eskyo/RAMBo/docs/images/Rambo-conn-main.jpg

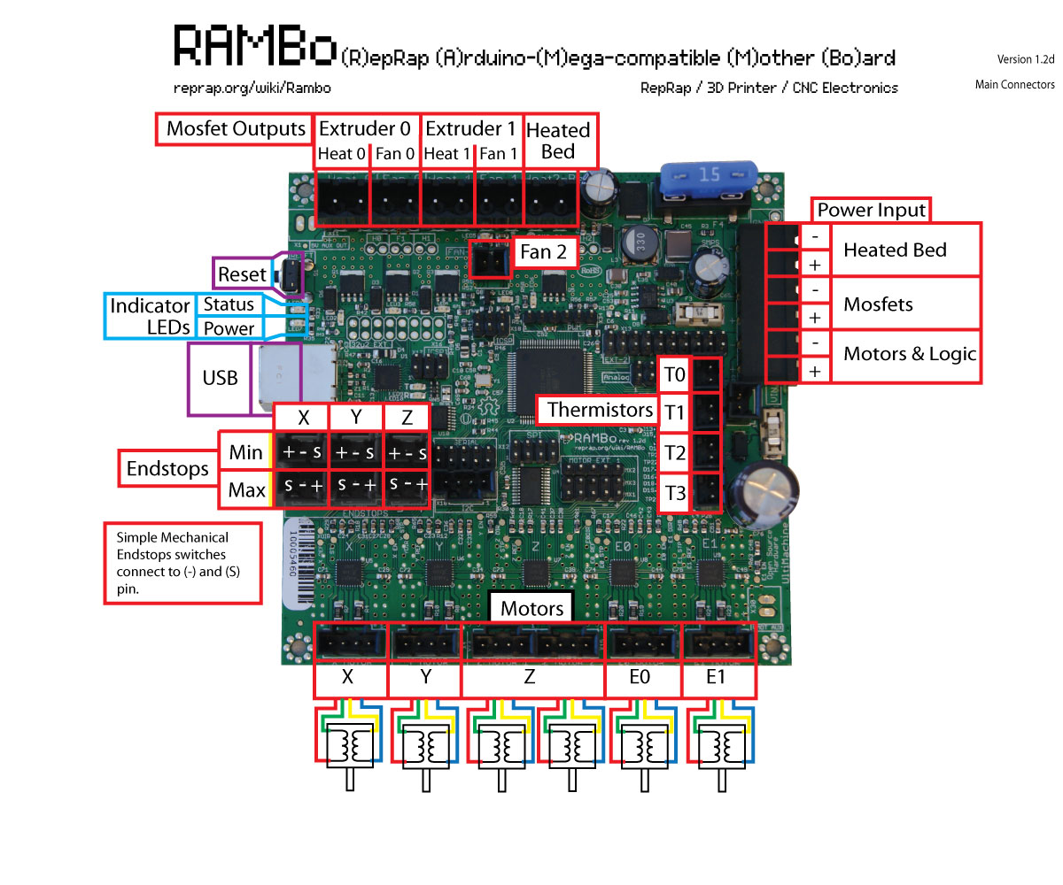
docs/images/Rambo-conn-main.jpg
