eskyo/RAMBo/docs/images/Rambo-fuses.jpg

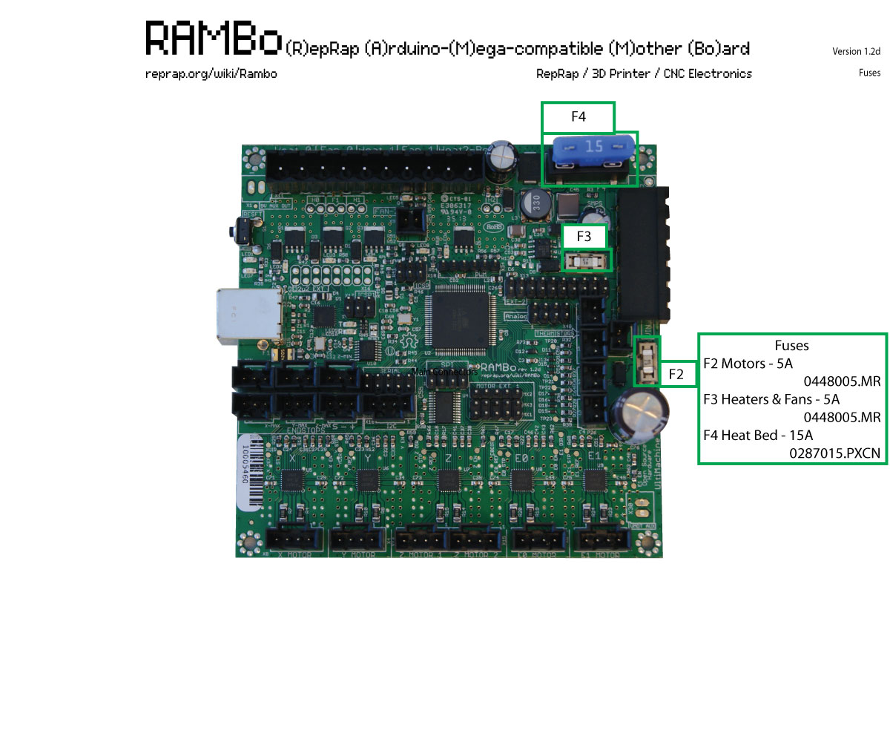
docs/images/Rambo-fuses.jpg
