eskyo/RAMBo/docs/images/Rambo-AuxConn.jpg

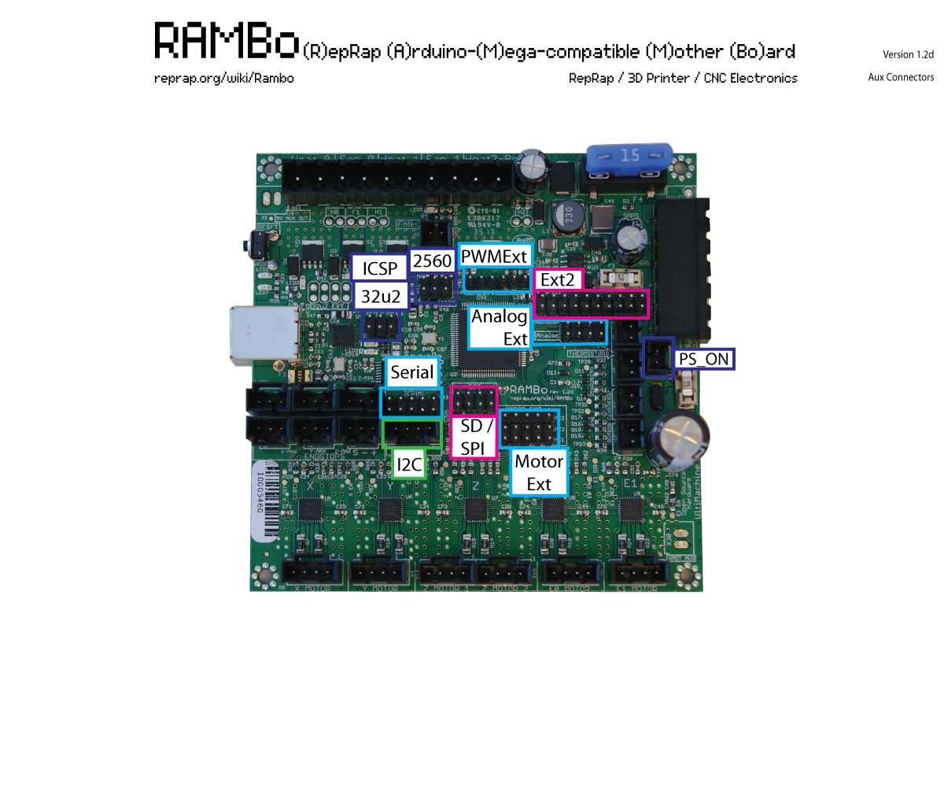
docs/images/Rambo-AuxConn.jpg
