eskyo/RAMBo/docs/images/RAMBo-board.jpg

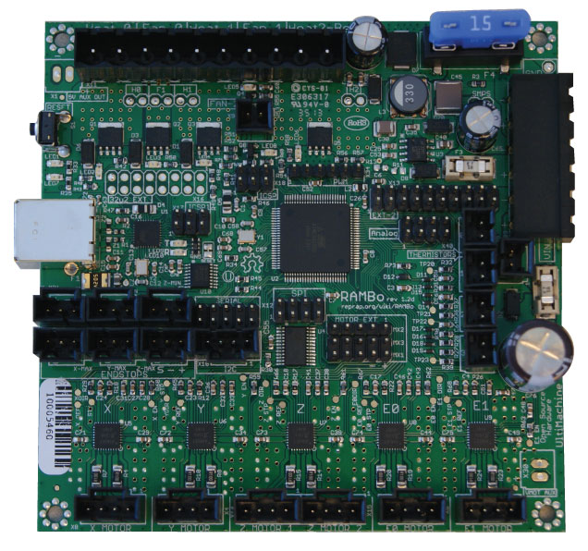
docs/images/RAMBo-board.jpg
