eskyo/RAMBo/docs/images/RAMBo-Schem.png

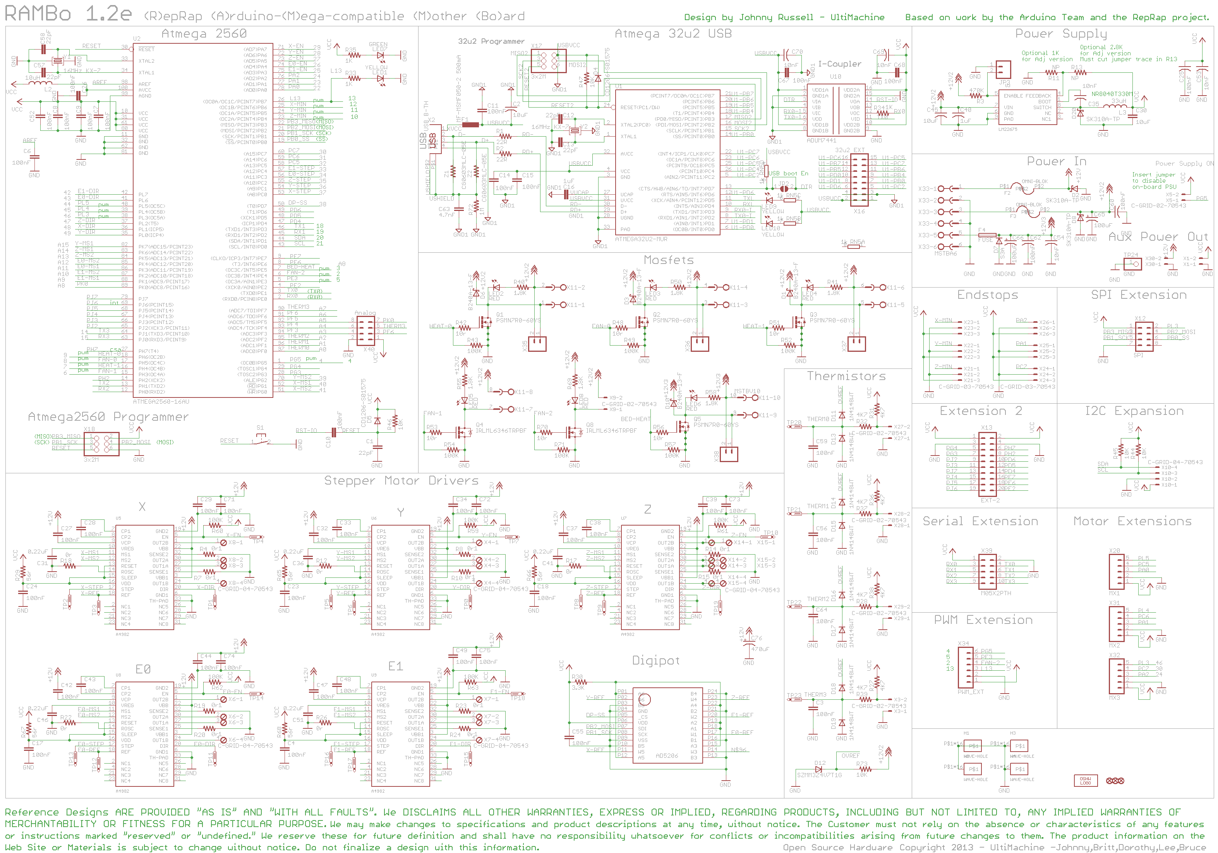
docs/images/RAMBo-Schem.png
