eskyo/RAMBo/docs/images/RAMBo-Silk.png

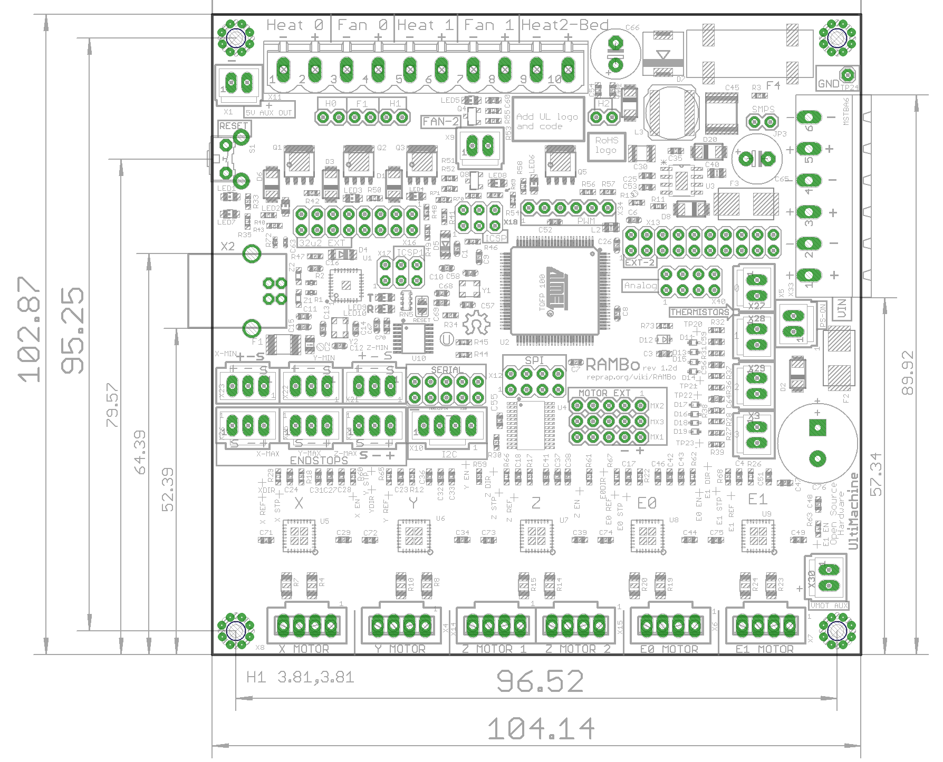
docs/images/RAMBo-Silk.png
