eskyo/RAMBo/past/motorExt1-1.jpg

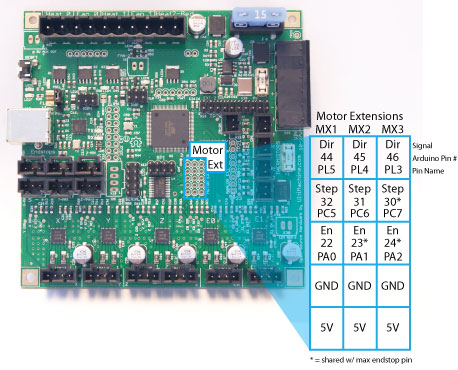
past/motorExt1-1.jpg
