eskyo/RAMBo/pogo_pin_jigs/1.2/RAMBo_top_plate.dxf

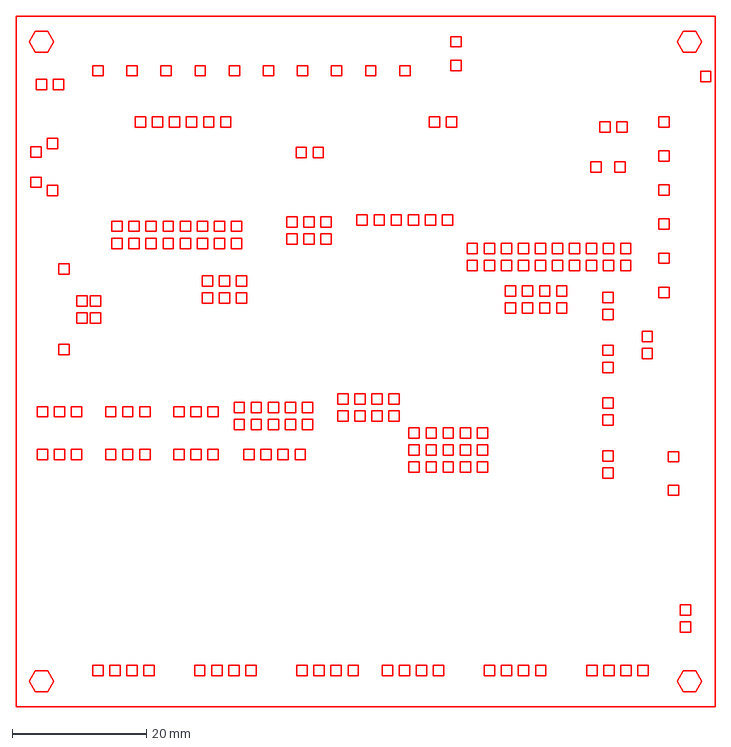
[picture p8: CAD file, 2013-10-01]
pogo_pin_jigs/1.2/RAMBo_top_plate.dxf
104.1 x 102.9 mm
