eskyo/RAMBo/pogo_pin_jigs/1.2/RAMBo_bottom_support.stl

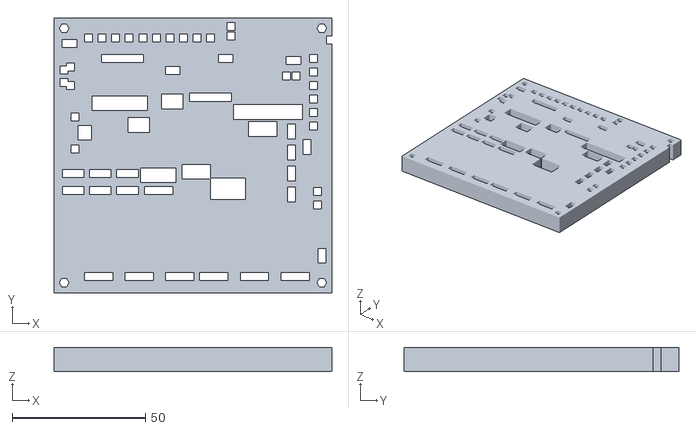
[picture p9: CAD file, 2013-10-01]
pogo_pin_jigs/1.2/RAMBo_bottom_support.stl
104.1 x 102.9 x 9.00
