eskyo/RAMBo/(list of files, cad)

Other CAD files:
pogo_pin_jigs/1.2/RAMBo_bottom_plate.scad
pogo_pin_jigs/1.2/RAMBo_bottom_support.scad
pogo_pin_jigs/1.2/RAMBo_top_plate.scad
