eskyo/RAMBo/docs/RAMBo-manual.pdf

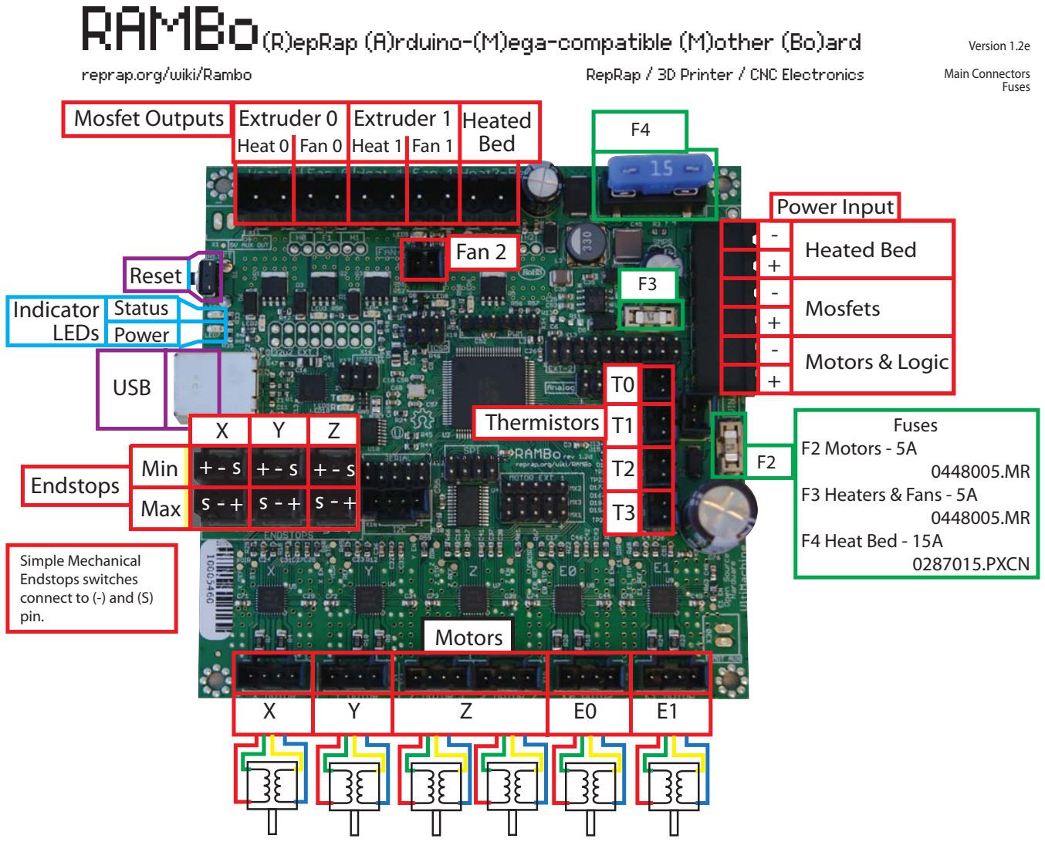
[picture p11: figure]
Fuses F2 Motors - 5A; 0448005.MR F3 Heaters & Fans - 5A 0448005.MR F4 Heat Bed - 15A 0287015.PXCN; Main Connectors; Fuses; Indicator LEDs; Status Power; Reset; USB; Heated Bed; Motors & Logic; Mosfets; Power Input; Mosfet Outputs; Extruder 0; Extruder 1; Fan 2; Heated; Heat 0; Fan 0; Heat 1; Fan 1; Bed; Thermistors; Motors; Endstops; Min; Max; Simple Mechanical Endstops switches connect to (-) and (S) pin.; Version 1.2e; RAMBo(R)epRap (A)rduino-(M)ega-compatible (M)other (Bo)ard

Open Source Hardware | Copyright 2012 - UltiMachine -Johnny,Britt,Dorothy,Lee, Bruce

Handle with care. Static Sensitive device.

!!! Reversing input power can destroy electronics and cause fire hazard!!!

Test all electronics thoroughly before placing into service.

Do not leave power supplied to electronics unattended, or run machines unattended due to the risk of fire and malfunction.

This is NOT a toy and it contains small and sharp parts. Children can choke or suffocate by swallowing small objects. Keep all parts away from children and never leave printer/parts unattended.

reprap.org/wiki/Rambo | RepRap / 3D Printer / CNC Electronics

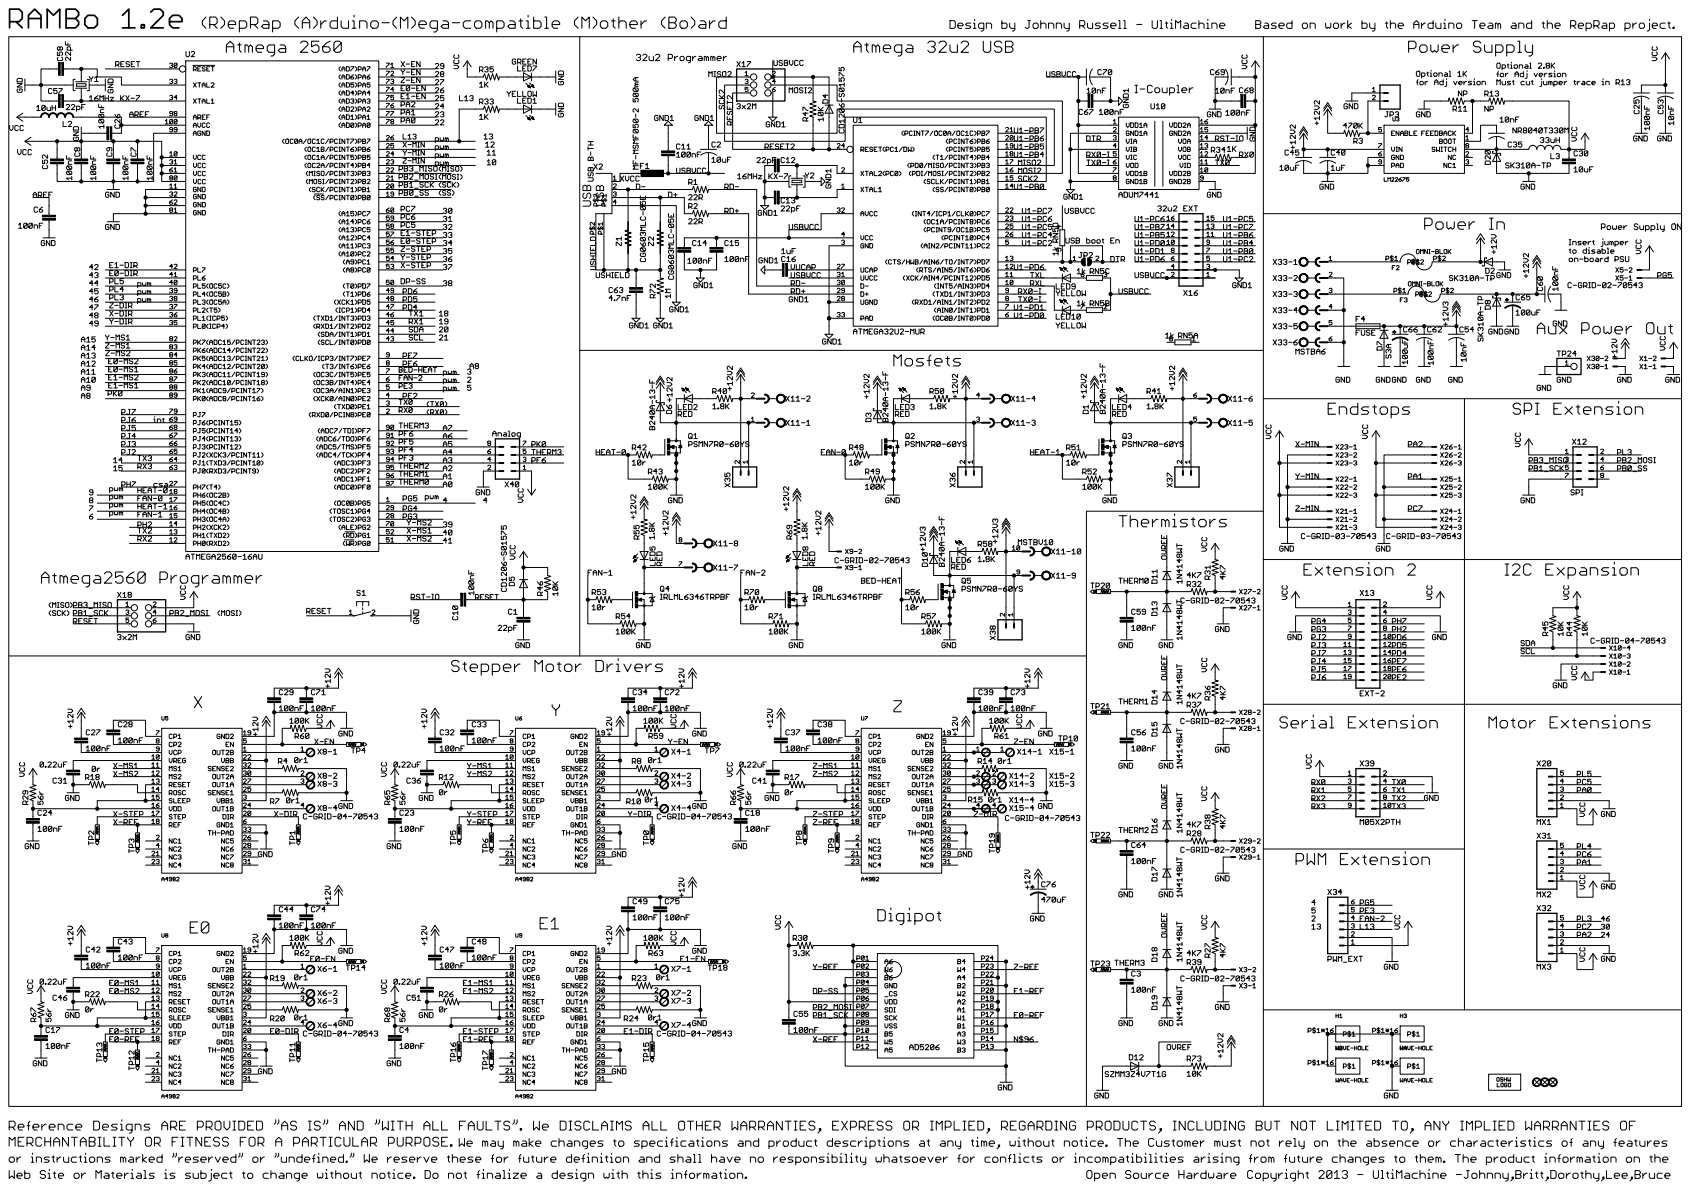
[picture p12: page 2]
