eskyo/RAMBo/board/RAMBo.brd

## EAGLE design board/RAMBo.brd (2013-12-26)

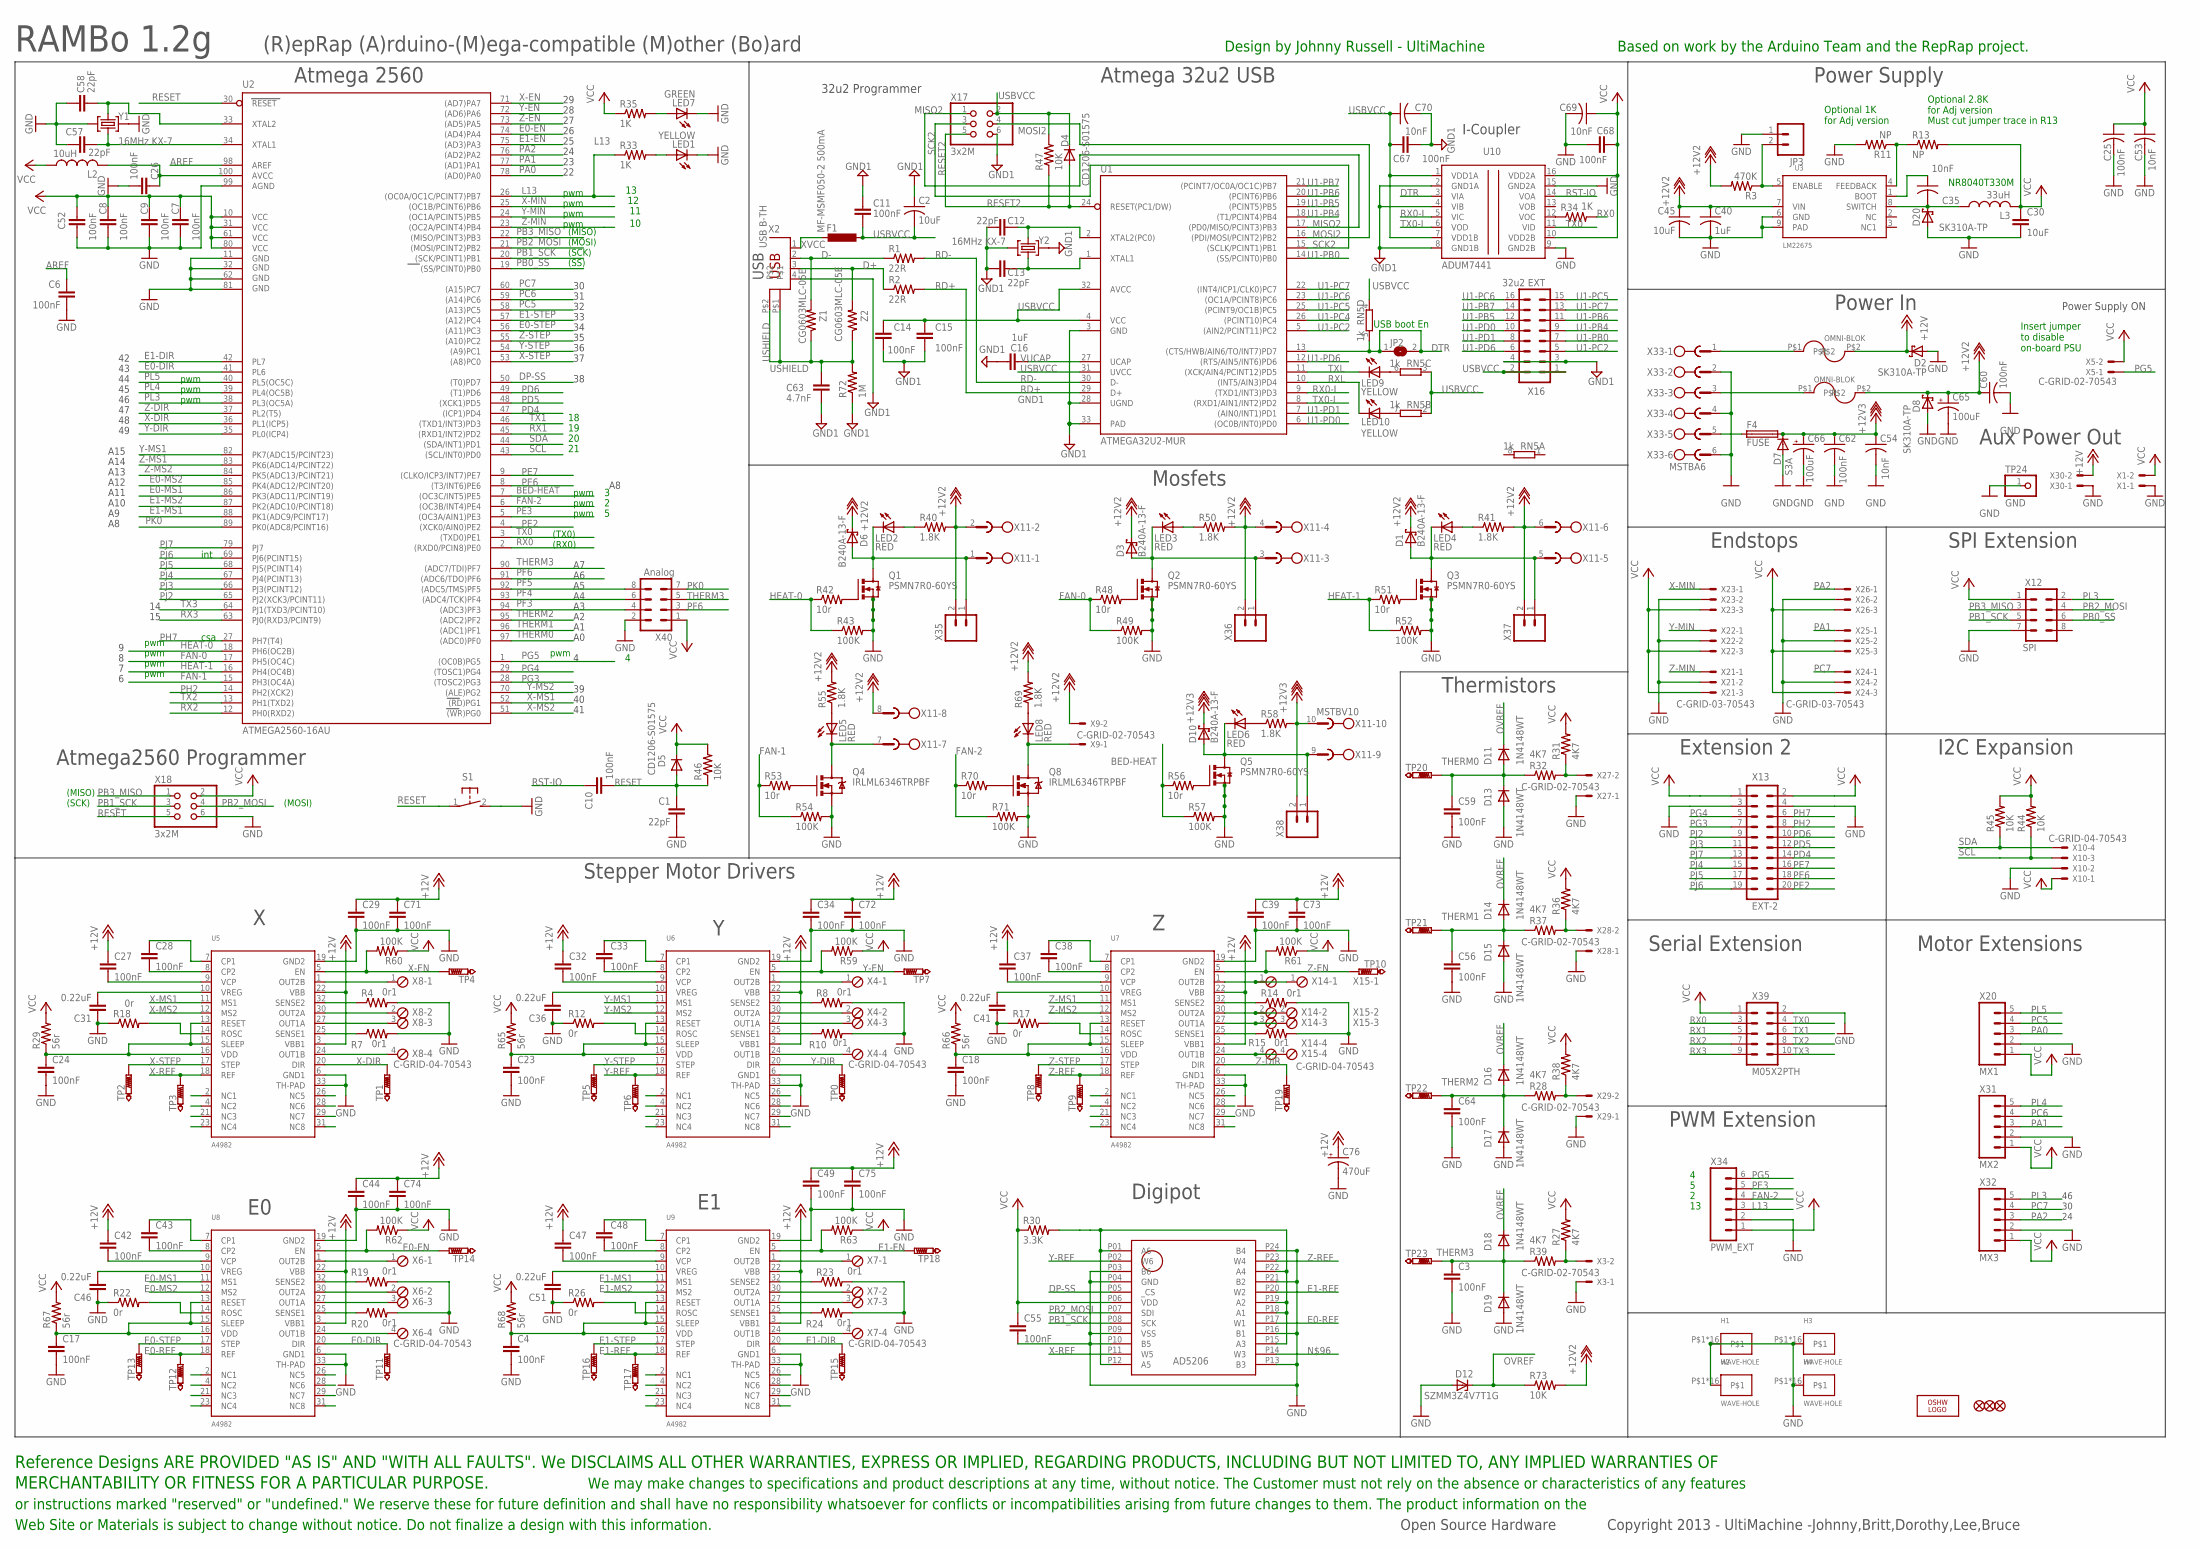
[picture p14: schematic RAMBo.sch]

Parts:
C1, C12, C13, C57, C58: 22pF; C0603
C2: 10uF; C0805
C3, C4, C6, C7, C8, C9, C10, C11, C14, C15, C17, C18, C23, C24, C25, C26, C27, C28, C29, C32, C33, C34, C37, C38, C39, C42, C43, C44, C47, C48, C49, C52, C55, C56, C59, C60, C62, C64, C67, C68, C71, C72, C73, C74, C75: 100nF; C0603
C16: 1uF; C0603
C30: 10uF; C1210K
C31, C36, C41, C46, C51: 0.22uF; C0603
C35, C53, C54, C69, C70: 10nF; C0603
C40: 1uF; C0805
C45: 10uF; C2220K
C63: 4.7nF; C0402
C65, C66: 100uF; E3,5-8
C76: 470uF; C12,5-5
D1, D3, D6, D10: B240A-13-F; SMA-SM
D2, D8, D20: SK310A-TP; SMA-SM
D4, D5: CD1206-S01575; MINIMELF
D7: S3A; DO-214AB
D11, D13, D14, D15, D16, D17, D18, D19: 1N4148WT; SOD523
D12: SZMM3Z4V7T1G; SOD323-R
F1: MF-MSMF050-2 500mA; L1812
F2, F3: OMNI-BLOK
F4: FUSE; FUSE-ATO-SMD
FID1, FID2, FID3: FIDUCIAL1X2; FIDUCIAL-1X2
H1, H2, H3, H4: WAVE-HOLE; 3,0-WAVE-HOLE
JP2: SJ
JP3: M02PTH; 1X02
L2: 10uH; C0805
L3: 33uH; NR8040
LED1, LED9, LED10: YELLOW; CHIP-LED0805
LED2, LED3, LED4, LED5, LED6, LED8: RED; CHIP-LED0805
LED7: GREEN; CHIP-LED0805
LOGO1: OSHW_LOGO_8MILX0150-NT; OSHW_8X150_NOTEXT
Q1, Q2, Q3, Q5: PSMN7R0-60YS; SOT669
Q4, Q8: IRLML6346TRPBF; SOT23-3
R1, R2: 22R; R0402
R3: 470K; R0603
R4, R7, R8, R10, R14, R15, R19, R20, R23, R24: 0r1; R1206
R11, R13: NP; R0603
R12, R17, R18, R22, R26: 0r; R0603
R27, R28, R31, R32, R36, R37, R38, R39: 4K7; R0603
R29, R65, R66, R67, R68: 56r; R0603
R30: 3.3K; R0603
R33, R34, R35: 1K; R0603
R40, R41, R50, R55, R58, R69: 1.8K; R0603
R42, R48, R51, R53, R56, R70: 10r; R0603
R43, R49, R52, R54, R57, R59, R60, R61, R62, R63, R71: 100K; R0603
R44, R45, R46, R47, R73: 10K; R0603
R72: 1M; R0402
RN5: 1k; CAY16
S1: 31-XX; B3F-31XX
TP0, TP1, TP2, TP3, TP4, TP5, TP6, TP7, TP8, TP9, TP10, TP11, TP12, TP13, TP14, TP15, TP16, TP17, TP18, TP19: PTR1B1,27TH; B1,27TH
TP20, TP21, TP22, TP23: PTR1B1,27; B1,27
TP24: GND; 1X01
U1: ATMEGA32U2-MUR; QFN32TROUND
U2: ATMEGA2560-16AU; TQFP100
U3: LM22675; SOIC127P600X170-9N
U4: AD5206; TSSOP24
U5, U6, U7, U8, U9: A4982; QFN32TROUND
U10: ADUM7441; QSOP16
X1, X3, X5, X9, X27, X28, X29, X30: C-GRID-02-70543; 70543-02
X2: USB B-TH; PN61729
X4, X6, X7, X8, X14, X15: C-GRID-04-70543; 4POL254
X10: C-GRID-04-70543; 70543-04
X11: MSTBV10
X12: SPI; 2X4
X13: EXT-2; 2X10
X16: 32u2 EXT; 2X8
X17, X18: 3x2M; 2X03
X20: MX1; 1X05
X21, X22, X23, X24, X25, X26: C-GRID-03-70543; 70543-03
X31: MX2; 1X05
X32: MX3; 1X05
X33: MSTBA6
X34: PWM_EXT; 1X06
X35, X36, X37, X38: M02PTH; 1X02
X39: M05X2PTH; AVR_ICSP
X40: Analog; 2X4
Y1, Y2: 16MHz KX-7; CRYSTAL-3.2-2.5
Z1, Z2: CG0603MLC-05E; R0603

Connections:
+12V: C27.1, C29.1, C32.1, C34.1, C37.1, C39.1, C42.1, C44.1, C47.1, C49.1, C71.1, C72.1, C73.1, C74.1, C75.1, C76.+, D2.C, F2.P$2, U5.3 (VBB1), U5.22 (VBB), U6.3 (VBB1), U6.22 (VBB), U7.3 (VBB1), U7.22 (VBB), U8.3 (VBB1), U8.22 (VBB), U9.3 (VBB1), U9.22 (VBB), X30.2
+12V2: C40.1, C45.1, C60.1, C65.+, D1.C, D3.C, D6.C, D8.C, F3.P$2, R3.2, R40.2, R41.2, R50.2, R55.2, R69.2, R73.2, U3.7 (VIN), X9.2, X11.2, X11.4, X11.6, X11.8, X35.2, X36.2, X37.2
+12V3: C54.1, C62.1, C66.+, D7.C, D10.C, F4.P$2 (2), R58.2, X11.10, X38.2
AREF: C6.1, U2.98 (AREF)
BED-HEAT: R56.1, R57.1, U2.7 ((OC3C/INT5)PE5)
D+: R2.1, X2.3, Z2.2
D-: R1.1, X2.2, Z1.2
DP-SS: U2.50 ((T0)PD7), U4.P05 (_CS)
DTR: JP2.1, JP2.2, RN5.5 (2), U1.13 ((CTS/HWB/AIN6/TO/INT7)PD7), U10.3 (VIA)
E0-DIR: TP11.TP, U2.41 (PL6), U8.20 (DIR)
E0-EN: R62.2, TP14.TP, U2.74 ((AD4)PA4), U8.5 (EN)
E0-MS1: U2.86 (PK3(ADC11/PCINT19)), U8.11 (MS1)
E0-MS2: U2.85 (PK4(ADC12/PCINT20)), U8.12 (MS2)
E0-REF: TP12.TP, U4.P17 (W1), U8.18 (REF)
E0-STEP: TP13.TP, U2.56 ((A11)PC3), U8.17 (STEP)
E1-DIR: TP15.TP, U2.42 (PL7), U9.20 (DIR)
E1-EN: R63.2, TP18.TP, U2.75 ((AD3)PA3), U9.5 (EN)
E1-MS1: U2.88 (PK1(ADC9/PCINT17)), U9.11 (MS1)
E1-MS2: U2.87 (PK2(ADC10/PCINT18)), U9.12 (MS2)
E1-REF: TP17.TP, U4.P20 (W2), U9.18 (REF)
E1-STEP: TP16.TP, U2.57 ((A12)PC4), U9.17 (STEP)
FAN-0: R48.1, R49.1, U2.17 (PH5(OC4C))
FAN-1: R53.1, R54.1, U2.15 (PH3(OC4A))
FAN-2: R70.1, R71.1, U2.6 ((OC3B/INT4)PE4), X34.4
GND: C1.2, C3.2, C4.2, C6.2, C7.2, C8.2, C9.2, C17.2, C18.2, C23.2, C24.2, C25.2, C26.2, C29.2, C30.2, C31.1, C34.2, C36.1, C39.2, C40.2, C41.1, C44.2, C45.2, C46.1, C49.2, C51.1, C52.2, C53.2, C54.2, C55.2, C56.2, C57.2, C58.2, C59.2, C60.2, C62.2, C64.2, C65.-, C66.-, C68.1, C69.2, C71.2, C72.2, C73.2, C74.2, C75.2, C76.-, D2.A, D7.A, D8.A, D12.A, D13.A, D15.A, D17.A, D19.A, D20.A, H1.P$1, H1.P$2, H1.P$3, H1.P$4, H1.P$5, H1.P$6, H1.P$7, H1.P$8, H1.P$17, H1.P$18, H1.P$19, H1.P$20, H1.P$21, H1.P$22, H1.P$23, H1.P$24, H2.P$1, H2.P$2, H2.P$3, H2.P$4, H2.P$5, H2.P$6, H2.P$7, H2.P$8, H2.P$17, H2.P$18, H2.P$19, H2.P$20, H2.P$21, H2.P$22, H2.P$23, H2.P$24, H3.P$1, H3.P$2, H3.P$3, H3.P$4, H3.P$5, H3.P$6, H3.P$7, H3.P$8, H3.P$17, H3.P$18, H3.P$19, H3.P$20, H3.P$21, H3.P$22, H3.P$23, H3.P$24, H4.P$1, H4.P$2, H4.P$3, H4.P$4, H4.P$5, H4.P$6, H4.P$7, H4.P$8, H4.P$17, H4.P$18, H4.P$19, H4.P$20, H4.P$21, H4.P$22, H4.P$23, H4.P$24, JP3.1, LED1.C, LED7.C, Q1.1 (S), Q1.2 (S), Q1.3 (S), Q2.1 (S), Q2.2 (S), Q2.3 (S), Q3.1 (S), Q3.2 (S), Q3.3 (S), Q4.2 (S), Q5.1 (S), Q5.2 (S), Q5.3 (S), Q8.2 (S), R4.2, R7.2, R8.2, R10.2, R11.2, R12.1, R14.2, R15.2, R17.1, R18.1, R19.2, R20.2, R22.1, R23.2, R24.2, R26.1, R43.2, R49.2, R52.2, R54.2, R57.2, R71.2, S1.2 (S), TP24.1, U2.11 (GND), U2.32 (GND1), U2.62 (GND2), U2.81 (GND3), U2.99 (AGND), U3.6 (GND), U3.9 (PAD), U4.P03 (B6), U4.P04 (GND), U4.P09 (VSS), U4.P10 (B5), U4.P13 (B3), U4.P16 (B1), U4.P21 (B2), U4.P24 (B4), U5.6 (GND1), U5.19 (GND2), U5.33 (TH-PAD), U6.6 (GND1), U6.19 (GND2), U6.33 (TH-PAD), U7.6 (GND1), U7.19 (GND2), U7.33 (TH-PAD), U8.6 (GND1), U8.19 (GND2), U8.33 (TH-PAD), U9.6 (GND1), U9.19 (GND2), U9.33 (TH-PAD), U10.9 (GND2B), U10.15 (GND2A), X1.1, X3.1, X10.2, X12.7, X13.3, X13.4, X18.6, X20.2, X21.2, X22.2, X23.2, X24.2, X25.2, X26.2, X27.1, X28.1, X29.1, X30.1, X31.2, X32.2, X33.2, X33.4, X33.6, X34.2, X39.2, X40.2, Y1.2 (GND), Y1.4 (GND)
GND1: C2.1, C11.2, C12.2, C13.2, C14.2, C15.2, C16.2, C63.2, C67.1, C70.2, R72.1, U1.3 (GND), U1.28 (UGND), U1.33 (PAD), U10.2 (GND1A), U10.4 (VIB), U10.8 (GND1B), X2.4, X16.3, X16.4, X17.6, Y2.2 (GND), Y2.4 (GND)
HEAT-0: R42.1, R43.1, U2.18 (PH6(OC2B))
HEAT-1: R51.1, R52.1, U2.16 (PH4(OC4B))
L13: R33.1, U2.26 ((OC0A/OC1C/PCINT7)PB7), X34.3
MISO2: U1.17 ((PD0/MISO/PCINT3)PB3), X17.1
MOSI2: U1.16 ((PDI/MOSI/PCINT2)PB2), X17.4
unnamed: C31.2, U5.10 (VREG)
unnamed: LED1.A, R33.2
unnamed: LED7.A, R35.2
unnamed: R8.1, U6.32 (SENSE2)
unnamed: R10.1, U6.25 (SENSE1)
unnamed: C33.2, U6.8 (CP2)
unnamed: C32.2, U6.9 (VCP)
unnamed: C36.2, U6.10 (VREG)
unnamed: R12.2, U6.14 (ROSC)
unnamed: Q4.1 (G), R53.2
unnamed: LED10.A, RN5.7 (2)
unnamed: C24.1, R29.1, U5.13 (RESET), U5.15 (SLEEP), U5.16 (VDD)
unnamed: F2.P$1, X33.1
unnamed: F3.P$1, X33.3
unnamed: JP3.2, R3.1, U3.5 (ENABLE)
unnamed: F4.P$1 (1), X33.5
unnamed: U6.30 (OUT2A), X4.2
unnamed: U6.27 (OUT1A), X4.3
unnamed: U6.24 (OUT1B), X4.4
unnamed: D6.A, LED2.C, Q1.MB (D), X11.1, X35.1
unnamed: R4.1, U5.32 (SENSE2)
unnamed: U6.1 (OUT2B), X4.1
unnamed: C33.1, U6.7 (CP1)
unnamed: C23.1, R65.1, U6.13 (RESET), U6.15 (SLEEP), U6.16 (VDD)
unnamed: Q2.4 (G), R48.2
unnamed: C26.1, L2.2, U2.100 (AVCC)
unnamed: R14.1, U7.32 (SENSE2)
unnamed: R15.1, U7.25 (SENSE1)
unnamed: C38.2, U7.8 (CP2)
unnamed: C37.2, U7.9 (VCP)
unnamed: C41.2, U7.10 (VREG)
unnamed: R17.2, U7.14 (ROSC)
unnamed: U7.30 (OUT2A), X14.2, X15.2
unnamed: U7.27 (OUT1A), X14.3, X15.3
unnamed: R7.1, U5.25 (SENSE1)
unnamed: C28.2, U5.8 (CP2)
unnamed: C27.2, U5.9 (VCP)
unnamed: U7.24 (OUT1B), X14.4, X15.4
unnamed: U7.1 (OUT2B), X14.1, X15.1
unnamed: C38.1, U7.7 (CP1)
unnamed: R18.2, U5.14 (ROSC)
unnamed: C18.1, R66.1, U7.13 (RESET), U7.15 (SLEEP), U7.16 (VDD)
unnamed: LED8.C, Q8.3 (D), X9.1
unnamed: R19.1, U8.32 (SENSE2)
unnamed: U5.1 (OUT2B), X8.1
unnamed: C28.1, U5.7 (CP1)
unnamed: R20.1, U8.25 (SENSE1)
unnamed: C43.2, U8.8 (CP2)
unnamed: U5.30 (OUT2A), X8.2
unnamed: U5.27 (OUT1A), X8.3
unnamed: U5.24 (OUT1B), X8.4
unnamed: LED9.A, RN5.6 (2)
unnamed: R34.1, U10.12 (VOC)
unnamed: C42.2, U8.9 (VCP)
unnamed: C46.2, U8.10 (VREG)
unnamed: R22.2, U8.14 (ROSC)
unnamed: U8.30 (OUT2A), X6.2
unnamed: U8.27 (OUT1A), X6.3
unnamed: U8.24 (OUT1B), X6.4
unnamed: U8.1 (OUT2B), X6.1
unnamed: C43.1, U8.7 (CP1)
unnamed: C17.1, R67.1, U8.13 (RESET), U8.15 (SLEEP), U8.16 (VDD)
unnamed: R23.1, U9.32 (SENSE2)
unnamed: R24.1, U9.25 (SENSE1)
unnamed: C48.2, U9.8 (CP2)
unnamed: C47.2, U9.9 (VCP)
unnamed: C51.2, U9.10 (VREG)
unnamed: R26.2, U9.14 (ROSC)
unnamed: U9.30 (OUT2A), X7.2
unnamed: U9.27 (OUT1A), X7.3
unnamed: U9.24 (OUT1B), X7.4
unnamed: U9.1 (OUT2B), X7.1
unnamed: C48.1, U9.7 (CP1)
unnamed: C4.1, R68.1, U9.13 (RESET), U9.15 (SLEEP), U9.16 (VDD)
unnamed: LED8.A, R69.1
unnamed: Q8.1 (G), R70.2
unnamed: LED2.A, R40.1
unnamed: R30.2, U4.P01 (A6), U4.P12 (A5), U4.P15 (A3), U4.P18 (A1), U4.P19 (A2), U4.P22 (A4)
unnamed: R31.1, R32.2, X27.2
unnamed: Q1.4 (G), R42.2
unnamed: R36.1, R37.2, X28.2
unnamed: Q3.4 (G), R51.2
unnamed: R28.2, R38.1, X29.2
unnamed: Q5.4 (G), R56.2
unnamed: D3.A, LED3.C, Q2.MB (D), X11.3, X36.1
unnamed: LED3.A, R50.1
unnamed: D1.A, LED4.C, Q3.MB (D), X11.5, X37.1
unnamed: LED4.A, R41.1
unnamed: LED5.C, Q4.3 (D), X11.7
unnamed: LED5.A, R55.1
unnamed: D10.A, LED6.C, Q5.MB (D), X11.9, X38.1
unnamed: LED6.A, R58.1
unnamed: R27.1, R39.2, X3.2
unnamed: C35.1, U3.1 (BOOT)
unnamed: R11.1, R13.1, U3.4 (FEEDBACK)
unnamed: C35.2, D20.C, L3.P$1 (1), U3.8 (SWITCH)
OVREF: D11.C, D12.C, D14.C, D16.C, D18.C, R73.1
PA0: U2.78 ((AD0)PA0), X20.3
PA1: U2.77 ((AD1)PA1), X25.1, X31.3
PA2: U2.76 ((AD2)PA2), X26.1, X32.3
PB0_SS: U2.19 ((SS/PCINT0)PB0), X12.6
PB1_SCK: U2.20 ((SCK/PCINT1)PB1), U4.P08 (SCK), X12.5, X18.3
PB2_MOSI: U2.21 ((MOSI/PCINT2)PB2), U4.P07 (SDI), X12.4, X18.4
PB3_MISO: U2.22 ((MISO/PCINT3)PB3), X12.3, X18.1
PC5: U2.58 ((A13)PC5), X20.4
PC6: U2.59 ((A14)PC6), X31.4
PC7: U2.60 ((A15)PC7), X24.1, X32.4
PD4: U2.47 ((ICP1)PD4), X13.14
PD5: U2.48 ((XCK1)PD5), X13.12
PD6: U2.49 ((T1)PD6), X13.10
PE2: U2.4 ((XCK0/AIN0)PE2), X13.20
PE3: U2.5 ((OC3A/AIN1)PE3), X34.5
PE6: U2.8 ((T3/INT6)PE6), X13.18
PE7: U2.9 ((CLKO/ICP3/INT7)PE7), X13.16
PF3: U2.94 ((ADC3)PF3), X40.4
PF4: U2.93 ((ADC4/TCK)PF4), X40.6
PF5: U2.92 ((ADC5/TMS)PF5), X40.8
PF6: U2.91 ((ADC6/TDO)PF6), X40.3
PG3: U2.28 ((TOSC2)PG3), X13.7
PG4: U2.29 ((TOSC1)PG4), X13.5
PG5: U2.1 ((OC0B)PG5), X5.1, X34.6
PH2: U2.14 (PH2(XCK2)), X13.8
PH7: U2.27 (PH7(T4)), X13.6
PJ2: U2.65 (PJ2(XCK3/PCINT11)), X13.9
PJ3: U2.66 (PJ3(PCINT12)), X13.11
PJ4: U2.67 (PJ4(PCINT13)), X13.15
PJ5: U2.68 (PJ5(PCINT14)), X13.17
PJ6: U2.69 (PJ6(PCINT15)), X13.19
PJ7: U2.79 (PJ7), X13.13
PK0: U2.89 (PK0(ADC8/PCINT16)), X40.7
PL3: U2.38 (PL3(OC5A)), X12.2, X32.5
PL4: U2.39 (PL4(OC5B)), X31.5
PL5: U2.40 (PL5(OC5C)), X20.5
RD+: R2.2, U1.29 (D+)
RD-: R1.2, U1.30 (D-)
RESET: C1.1, C10.2, D5.A, R46.1, S1.1, U2.30 (RESET), X18.5
RESET2: D4.A, R47.1, U1.24 (RESET(PC1/DW)), X17.5
RST-IO: C10.1, U10.14 (VOA)
RX0: R34.2, U2.2 ((RXD0/PCIN8)PE0), X39.3
RX0-I: U1.9 ((TXD1/INT3)PD3), U10.5 (VIC)
RX1: U2.45 ((RXD1/INT2)PD2), X39.5
RX2: U2.12 (PH0(RXD2)), X39.7
RX3: U2.63 (PJ0(RXD3/PCINT9)), X39.9
RXL: LED10.C, U1.10 ((INT5/AIN3)PD4)
SCK2: U1.15 ((SCLK/PCINT1)PB1), X17.3
SCL: R45.1, U2.43 ((SCL/INT0)PD0), X10.4
SDA: R44.1, U2.44 ((SDA/INT1)PD1), X10.3
THERM0: C59.1, D11.A, D13.C, R32.1, TP20.TP, U2.97 ((ADC0)PF0)
THERM1: C56.1, D14.A, D15.C, R37.1, TP21.TP, U2.96 ((ADC1)PF1)
THERM2: C64.1, D16.A, D17.C, R28.1, TP22.TP, U2.95 ((ADC2)PF2)
THERM3: C3.1, D18.A, D19.C, R39.1, TP23.TP, U2.90 ((ADC7/TDI)PF7), X40.5
TX0: U2.3 ((TXD0)PE1), U10.11 (VID), X39.4
TX0-I: U1.8 ((RXD1/AIN1/INT2)PD2), U10.6 (VOD)
TX1: U2.46 ((TXD1/INT3)PD3), X39.6
TX2: U2.13 (PH1(TXD2)), X39.8
TX3: U2.64 (PJ1(TXD3/PCINT10)), X39.10
TXL: LED9.C, U1.11 ((XCK/AIN4/PCINT12)PD5)
U1-PB0: U1.14 ((SS/PCINT0)PB0), X16.7
U1-PB4: U1.18 ((T1/PCINT4)PB4), X16.9
U1-PB5: U1.19 ((PCINT5)PB5), X16.12
U1-PB6: U1.20 ((PCINT6)PB6), X16.11
U1-PB7: U1.21 ((PCINT7/OC0A/OC1C)PB7), X16.14
U1-PC2: U1.5 ((AIN2/PCINT11)PC2), X16.5
U1-PC4: U1.26 ((PCINT10)PC4)
U1-PC5: U1.25 ((PCINT9/OC1B)PC5), X16.15
U1-PC6: U1.23 ((OC1A/PCINT8)PC6), X16.16
U1-PC7: U1.22 ((INT4/ICP1/CLK0)PC7), X16.13
U1-PD0: U1.6 ((OC0B/INT0)PD0), X16.10
U1-PD1: U1.7 ((AIN0/INT1)PD1), X16.8
U1-PD6: U1.12 ((RTS/AIN5/INT6)PD6), X16.6
USBVCC: C2.2, C11.1, C14.1, C15.1, C67.2, C70.1, D4.C, F1.1, R47.2, RN5.2 (1), RN5.3 (1), RN5.4 (1), U1.4 (VCC), U1.31 (UVCC), U1.32 (AVCC), U10.1 (VDD1A), U10.7 (VDD1B), X16.1, X16.2, X17.2
USHIELD: C63.1, R72.2, X2.P$1, X2.P$2, Z1.1, Z2.1
VCC: C7.1, C8.1, C9.1, C25.1, C30.1, C52.1, C53.1, C55.1, C68.2, C69.1, D5.C, L2.1, L3.P$2 (2), R13.2, R27.2, R29.2, R30.1, R31.2, R35.1, R36.2, R38.2, R44.2, R45.2, R46.2, R59.1, R60.1, R61.1, R62.1, R63.1, R65.2, R66.2, R67.2, R68.2, U2.10 (VCC), U2.31 (VCC1), U2.61 (VCC2), U2.80 (VCC3), U4.P06 (VDD), U10.10 (VDD2B), U10.16 (VDD2A), X1.2, X5.2, X10.1, X12.1, X13.1, X13.2, X18.2, X20.1, X21.3, X22.3, X23.3, X24.3, X25.3, X26.3, X31.1, X32.1, X34.1, X39.1, X40.1
VUCAP: C16.1, U1.27 (UCAP)
X-DIR: TP1.TP, U2.36 (PL1(ICP5)), U5.20 (DIR)
X-EN: R60.2, TP4.TP, U2.71 ((AD7)PA7), U5.5 (EN)
X-MIN: U2.25 ((OC1B/PCINT6)PB6), X23.1
X-MS1: U2.52 ((RD)PG1), U5.11 (MS1)
X-MS2: U2.51 ((WR)PG0), U5.12 (MS2)
X-REF: TP3.TP, U4.P11 (W5), U5.18 (REF)
X-STEP: TP2.TP, U2.53 ((A8)PC0), U5.17 (STEP)
XT1: C13.1, U1.1 (XTAL1), Y2.1 (C1)
XT2: C12.1, U1.2 (XTAL2(PC0)), Y2.3 (C2)
XTAL1: C57.1, U2.34 (XTAL1), Y1.1 (C1)
XTAL2: C58.1, U2.33 (XTAL2), Y1.3 (C2)
XVCC: F1.2, X2.1
Y-DIR: TP0.TP, U2.35 (PL0(ICP4)), U6.20 (DIR)
Y-EN: R59.2, TP7.TP, U2.72 ((AD6)PA6), U6.5 (EN)
Y-MIN: U2.24 ((OC1A/PCINT5)PB5), X22.1
Y-MS1: U2.82 (PK7(ADC15/PCINT23)), U6.11 (MS1)
Y-MS2: U2.70 ((ALE)PG2), U6.12 (MS2)
Y-REF: TP6.TP, U4.P02 (W6), U6.18 (REF)
Y-STEP: TP5.TP, U2.54 ((A9)PC1), U6.17 (STEP)
Z-DIR: TP19.TP, U2.37 (PL2(T5)), U7.20 (DIR)
Z-EN: R61.2, TP10.TP, U2.73 ((AD5)PA5), U7.5 (EN)
Z-MIN: U2.23 ((OC2A/PCINT4)PB4), X21.1
Z-MS1: U2.83 (PK6(ADC14/PCINT22)), U7.11 (MS1)
Z-MS2: U2.84 (PK5(ADC13/PCINT21)), U7.12 (MS2)
Z-REF: TP9.TP, U4.P23 (W4), U7.18 (REF)
Z-STEP: TP8.TP, U2.55 ((A10)PC2), U7.17 (STEP)

Notes on the sheet:
(SCK)
(MISO)
(MOSI)
pwm
(TX0)
(RX0)
USB boot En
int
csa
(SS)
Reference Designs ARE PROVIDED "AS IS" AND "WITH ALL FAULTS". We DISCLAIMS ALL OTHER WARRANTIES, EXPRESS OR IMPLIED, REGARDING PRODUCTS, INCLUDING BUT NOT LIMITED TO, ANY IMPLIED WARRANTIES OF
MERCHANTABILITY OR FITNESS FOR A PARTICULAR PURPOSE.
or instructions marked "reserved" or "undefined." We reserve these for future definition and shall have no responsibility whatsoever for conflicts or incompatibilities arising from future changes to them. The product information on the
Web Site or Materials is subject to change without notice. Do not finalize a design with this information.
A10
A11
A12
A13
A14
A15
Motor Extensions
SPI Extension
PWM Extension
RAMBo 1.2g
Atmega 32u2 USB
I2C Expansion
Atmega2560 Programmer
Power In
Power Supply
Stepper Motor Drivers
Digipot
Thermistors
Mosfets
Aux Power Out
Design by Johnny Russell - UltiMachine
Based on work by the Arduino Team and the RepRap project.
(R)epRap (A)rduino-(M)ega-compatible (M)other (Bo)ard
Serial Extension
Endstops
Atmega 2560
Extension 2
Copyright 2013 - UltiMachine -Johnny,Britt,Dorothy,Lee,Bruce
We may make changes to specifications and product descriptions at any time, without notice. The Customer must not rely on the absence or characteristics of any features
Open Source Hardware
USB
32u2 Programmer
Power Supply ON
AD5206
Optional 1K for Adj version
Optional 2.8K for Adj version
Must cut jumper trace in R13
NR8040T330M
I-Coupler
Insert jumper to disable on-board PSU

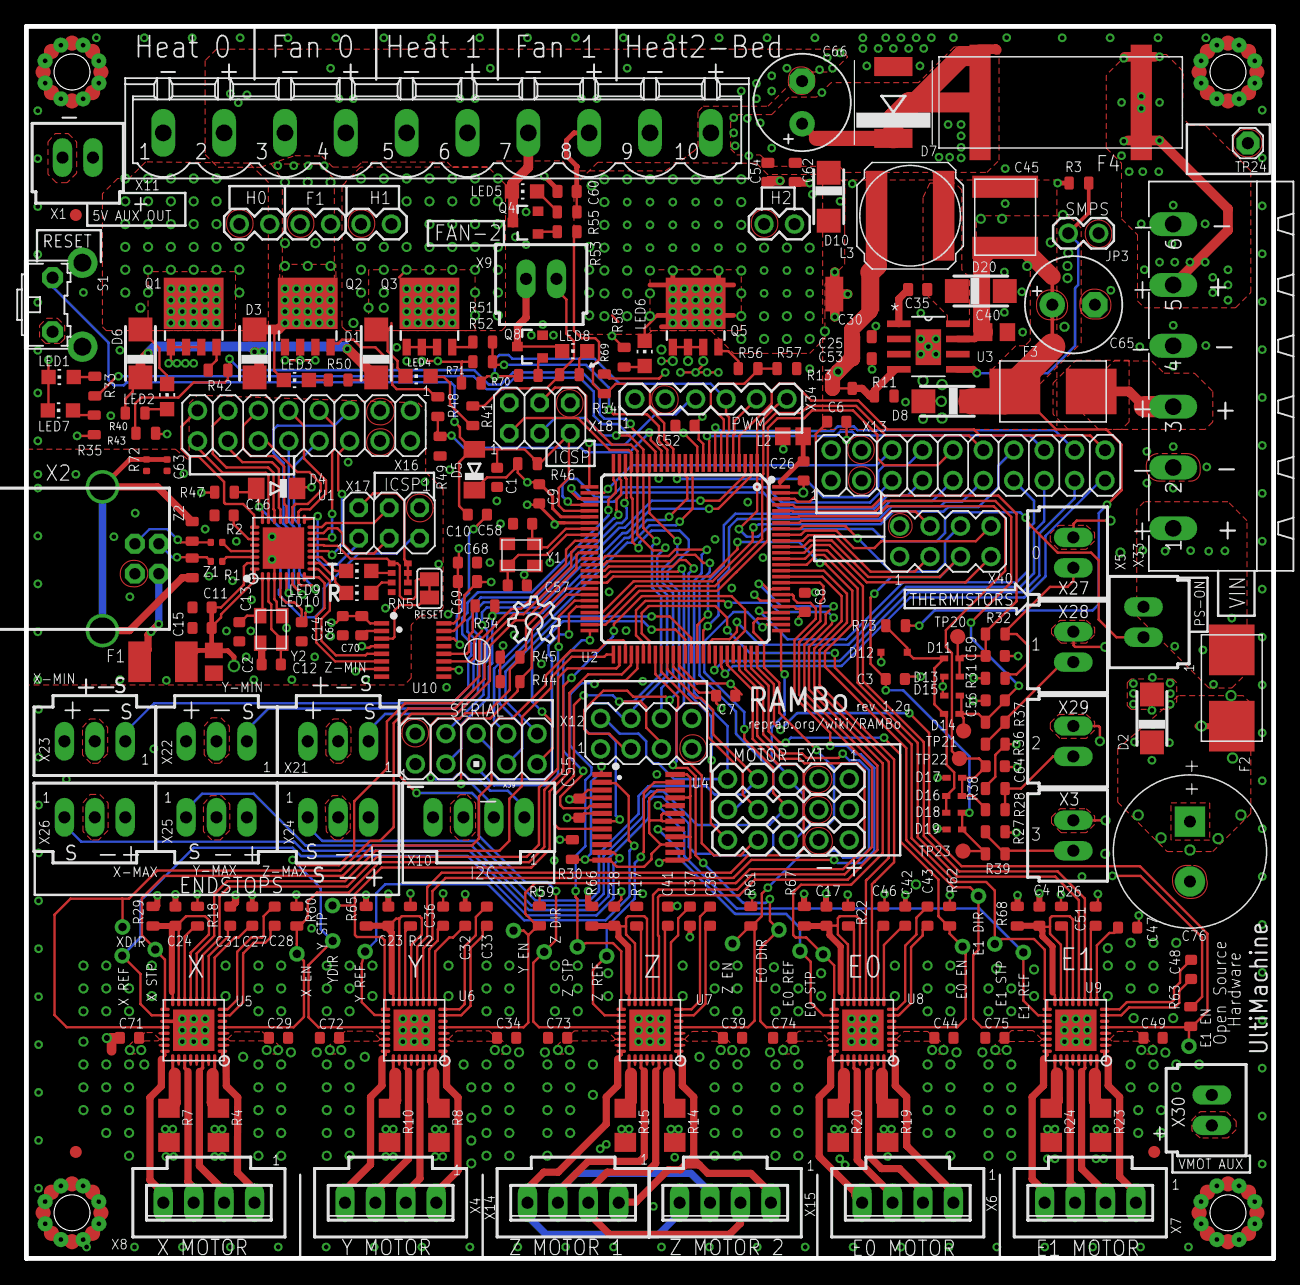
[picture p15: board RAMBo.brd from above]

Board: 4 copper layers, 104.1 x 102.9 mm, 266 parts (0 on the bottom side), 230 nets.
