eskyo/RAMBo/(commit log)

2013-12-26 fix rotated varistors on schematic, no EDC
    increment schematic label to 1.2g
    [RAMBo.sch]
2013-12-26 add more gerbers - 1-2g is not tested yet
